dany2701/BOM-project/Project/CAD/Main.png

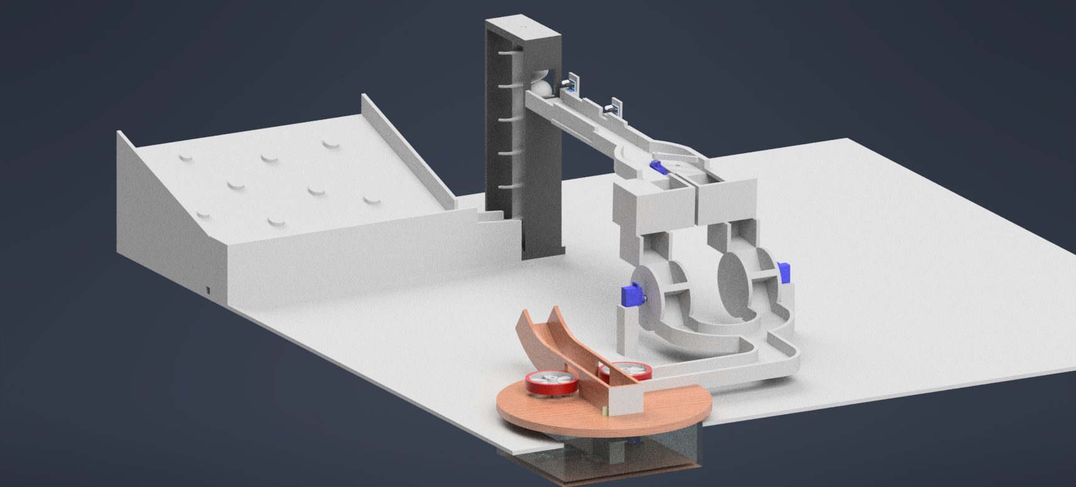
Project/CAD/Main.png
