dany2701/BOM-project/Project/Documentation/Actuator_Sizing_Report_Gate2.docx

ACTUATOR SIZING FOR SORTING MECHANISM

For the sizing of the actuator used to move the gate ,I have decided that it must be a servo motor to be able to move the gate between 2 exact positions , however I had to do some calculations in order to find the model needed to achieve the needed motion.

# 1. Gate Physical Properties

The following data was extracted directly from Autodesk Inventor iProperties for the gate2 component. The gate is manufactured from MDF Medium Density Fiberboard with a density of 0.800 g/cm³.

Parameter | Value | Unit
Mass | 0.001 | kg (~1 g)
Volume | 1643.915 | mm³
Surface Area | 1428.832 | mm²
CoG Offset X | -1.223 | mm
CoG Offset Y | -2.168 | mm
CoG Offset Z | 1.500 | mm
Principal Moment I1 | 0.400 | kg·mm²
Principal Moment I2 | 0.009 | kg·mm²
Principal Moment I3 | 0.398 | kg·mm²
Material | MDF Medium Density Fiberboard | —
Density | 0.800 | g/cm³

# 2. Operating Parameters

The following operating conditions were specified for the sorting mechanism:

Parameter | Value | Notes
Swing Range | 40° – 120° | 80° total travel
Operating Speed | < 0.3 s per stroke | Fast sorting cycle

# 3. Torque Analysis

## 3.1 Effective Moment of Inertia

For a center-pivot gate, the effective rotational inertia about the pivot axis is taken as the average of the two principal moments in the plane of rotation (I1 and I3):

I_eff: (I1 + I3) / 2 = (0.400 + 0.398) / 2 = 0.399 kg·mm² = 3.99 × 10⁻⁷ kg·m²

## 3.2 Static Gravitational Torque

The moment arm is the horizontal projection of the CoG offset from the pivot centre. The dominant offset is in Y (2.168 mm):

τ_grav: m × g × r_CoG = 0.001 × 9.81 × 0.00217 ≈ 0.0000213 N·m ≈ 0.021 mN·m

## 3.3 Dynamic (Acceleration) Torque

Assuming constant angular acceleration to traverse 80° (1.396 rad) in 0.3 s:

α: 2θ / t² = 2 × 1.396 / 0.3² ≈ 31.0 rad/s²

τ_acc: I_eff × α = 3.99×10⁻⁷ × 31.0 ≈ 0.0124 mN·m ≈ 0.012 mN·m

## 3.4 Design Torque with Safety Factor

A safety factor of 3× is applied to account for payload impact forces, air resistance, and mechanical wear. An additional 10–20% is added for friction losses at the pivot bearing:

τ_design: (τ_grav + τ_acc) × 3 × 1.15 ≈ 0.033 × 3.45 ≈ 0.114 → rounded to 0.12 mN·m

Torque Component | Value | Formula / Basis
Static gravitational | 0.021 mN·m | m × g × r_CoG
Dynamic (acceleration) | 0.012 mN·m | I_eff × α
Raw total | 0.033 mN·m | Static + dynamic
With safety factor (3×) | 0.099 mN·m | 3× margin applied
Design torque (+ friction) | 0.12 mN·m | Rounded up for losses

# 4. Servo Selection Criteria

The following minimum specifications are required for the servo actuator. Speed is the binding constraint — the gate mass is negligible (~1 g), so torque margin is very large with any standard hobby servo.

Parameter | Required | Rationale | Priority
Stall torque | ≥ 0.5 mN·m | 5× margin over design | Low
Speed | ≥ 266 °/s | 80° in < 0.3 s | CRITICAL
Rotation range | ≥ 80° travel | Full gate sweep | High
Resolution | ≤ 1° preferred | Accurate gate stop | Medium
Supply voltage | 3.3 V or 5 V | MCU compatibility | Medium

# 5. Recommended Servo Options

All three options below provide 150–200× more torque than required. Selection is driven entirely by speed capability and physical size constraints.

Model | Torque | Speed | Weight | Notes
MG90S | 22 mN·m | ~500 °/s | 13 g | Metal gear, durable
DS-929MG | 30 mN·m | ~460 °/s | 11 g | Higher torque margin

# 7. Summary

The gate2 component is extremely lightweight (~1 g, MDF) with a symmetrical center-pivot configuration. Torque demand is negligible at 0.12 mN·m design torque. Any standard micro-servo exceeds this by 150× or more. The sole engineering constraint is cycle speed: the mechanism requires 80° of travel in under 0.3 s, demanding a servo rated at ≥ 266 °/s. The SG90/SG92R family (600 °/s) is the optimal choice — compact, fast, inexpensive, and widely available.
