dany2701/BOM-project/Project/Documentation/PDS_Formatted.docx

PRODUCT DESIGN SPECIFICATION

━━━━━━━━━━━━━━━━━━━━━━━━━━━━

Closed-Loop Single-Player Shooting Game Toy

DEFENSE MECHANISM

PROJECT TEAM

━━━━━━━━━━━━━━━━

1 | Yassien Ayman, 24P0112
2 | Abdullah Amr, 24P0206
3 | Daniel Youssef, 24P0321
4 | Farah Yasser, 24P
5 | Shahd Khalifa, 24P

━━━━━━━━━━━━━━━━

1 PRODUCT OVERVIEW

The proposed system is an automated, closed-loop interactive game designed for one player, combining mechanical motion and intelligent sorting to create an engaging experience. It is intended for use as a children's toy (ages 2–10) and as an entertainment system.

Balls are fed through a gravity-based slide and launched using a joystick-controlled shooting mechanism. They then move through a guided pathway involving transport, elevation using an Archimedes screw, and color-based classification.

A sensing unit detects the color of each ball (white or black), and a sorting mechanism directs them into designated channels. The balls are then returned to the shooting area, forming a continuous closed-loop cycle.

The system ensures smooth operation through synchronization between mechanical components and sensors. It is suitable for, mechatronics applications, and interactive gameplay due to its integration of multiple engineering principles.

2 OBJECTIVES

- Develop an integrated system combining mechanical motion, sensing, and control into a single functional unit.
- Design a reliable mechanism for continuous ball circulation within a closed-loop system.
- Achieve fast and accurate color-based classification of balls.
- Ensure smooth and reliable mechanical movement throughout all stages of the system.
- Optimize the system to minimize delays, energy consumption, and mechanical losses.
- Incorporate a user-friendly interface to allow players to interact with and monitor the system easily.
- Improve user engagement by integrating interactive and competitive elements.
- Design the system to be suitable for entertainment and mechatronics applications.

3 TARGET AUDIENCE

Primary Users

- Children aged 2 to 10 years.
- Parents and guardians supervising gameplay.
- Suitable for homes, nurseries, and early learning environments.

Secondary Users

- Engineering and mechatronics students.
- Educational institutions (labs and demonstrations).

4 POWER CONSUMPTION

The system operates using low-voltage DC power (5V–12V) for safety and portability. The main power consumers are actuators, sensors, and the control unit.

Power consumption is kept low to moderate depending on motor load, with peak usage occurring when multiple actuators operate simultaneously.

Efficiency is improved by using gravity-fed ball movement and sensor-based activation, ensuring that components only operate when required.

5 FUNCTIONAL REQUIREMENTS

5.1. Ball Feeding System

- The system shall include a gravity-fed slide mechanism that delivers balls directly to the shooting mechanism.
- Balls shall be placed on the slide before operation begins.
- No manual insertion of balls shall be required during operation.

5.2. Shooting Mechanism

- The shooting mechanism shall launch one ball at a time in a controlled manner.
- The shooting mechanism shall receive balls automatically from the gravity-fed slide.
- The shooting action shall be triggered by the user using a joystick interface.
- The system shall ensure consistent shooting force for each launch.
- The system shall ensure smooth transition of balls from the slide into the shooting unit without jamming.

5.3. Joystick Control

- The system shall include a joystick for user interaction.
- The joystick shall be used to control the shooting action (activation and timing).
- The system shall respond to joystick input in real time.
- The joystick shall be able to control shooting direction
- Input signals shall be converted into control signals for the shooting mechanism.

5.4. Lifting Mechanism

- The system shall use an Archimedes screw mechanism to lift balls from the lower level to the upper sorting stage.
- The screw shall rotate to transport balls vertically in a continuous and controlled manner.
- An entry sensor at the base of the lifting mechanism shall trigger the motor to start rotating when a ball is detected.
- An exit sensor at the top of the lifting mechanism shall stop the motor when a ball has cleared the screw.
- The lifting mechanism shall ensure smooth transfer of balls without jamming or delay.
- The system shall maintain continuous operation based on sensor feedback for efficient ball transport.
- The lifting motor has been selected based on torque requirements derived from the weight of a single ball and screw radius, with a suitable safety factor applied.

5.5. Sorting Mechanism

- The system shall include a color detection unit to identify balls as white or black.
- Color detection shall occur after the ball exits the lifting mechanism.
- The system shall process sensor input in real time to determine ball color.
- The system shall include a mechanical sorting gate to direct balls based on detected color:
- White balls → Designated white path
- Black balls → Designated black path
- The sorting mechanism shall operate automatically without user intervention.
- The system shall ensure high accuracy in sorting and minimize misclassification.

5.6. Closed-Loop Operation

- The system shall operate as a continuous closed-loop cycle without manual resetting.
- After sorting, balls shall be automatically returned to the initial shooting region.
- The return system shall ensure smooth transport of balls back to the gravity-fed slide.
- The system shall ensure synchronization between: the shooting mechanism, the lifting system, and the sorting system.
- The loop shall only stop when the system is manually powered off.

6 NON-FUNCTIONAL REQUIREMENTS

6.1. Reliability & Performance

- The system shall operate continuously for extended periods without failure.
- Smooth and continuous ball movement shall be maintained without jamming.
- The shooting mechanism shall respond reliably to joystick input.
- The lifting mechanism shall operate consistently using sensor feedback.
- The system shall accurately sort balls into white and black categories.
- Stable performance shall be maintained during repeated gameplay.

6.2. Safety

- The system shall enclose all moving parts to prevent user injury.
- The system shall operate using low-voltage electrical components.
- Materials shall be non-toxic and safe for children.
- Edges and surfaces shall be smooth and rounded.
- All electrical wiring shall be fully enclosed within the chassis to prevent user contact and tampering.

6.3. Usability

- The system shall be easy to use with simple controls.
- The system shall require minimal setup before operation.
- The interface shall be understandable for children aged 2–10 years.

6.4. Product Lifespan

- The system shall be designed for repeated use over long periods.
- Mechanical components shall withstand frequent operation.
- The product shall maintain functionality with proper use and care.

6.5. Size & Weight

- The weight shall be manageable to allow easy movement by adults.
- The dimensions shall ensure safe interaction and accessibility for children.
- The layout shall efficiently utilize a 100 cm × 100 cm area to accommodate all mechanical and electronic components.

6.6. Maintainability

- Easy access to internal components shall be provided.
- Ball pathways and sensors shall be simple to clean.
- Mechanical and electrical parts shall be replaceable.

6.7. Aesthetic Considerations

- The design shall be colorful and visually attractive to children.
- A war themed design is included to appeal to the respected audience
- The system layout shall be clean and organized.
- Functional areas shall be clearly distinguishable.

6.8. Ergonomics & User Interaction

- The joystick shall be easy to use for small hands.
- Controls shall require minimal force to operate.
- The interface shall be simple and understandable for children.
- The design shall ensure comfortable and safe interaction.

6.9. Manufacturing

- 3D printing shall be used for complex mechanical parts.
- Laser cutting shall be used for structural components.
- Standard assembly methods such as screws and fittings shall be used.
- Materials such as PLA shall be selected for safety and availability.

7 OPERATIONAL SPEED & EFFICIENCY

The system is designed for continuous and stable operation rather than high speed. Balls move through a closed-loop cycle involving feeding, shooting, lifting, sorting, and return.

Efficiency is achieved through gravity-assisted movement, real-time sensor control, and synchronized subsystem operation. This reduces delays, prevents congestion, and ensures smooth circulation of balls throughout the system.

8 SYSTEM COMPONENTS

8.1 Mechanical Components

- Shooting mechanism (spring or motor-based)
- Ball transport channels
- Lifting system (Archimedes screw)
- Sorting gates
- Frame and housing

8.2 Electrical Components

- DC motors
- Servo motors
- Motor driver
- Power supply
- IR sensors
- Control circuit (microcontroller)

9 INPUTS & OUTPUTS

Inputs | Outputs
Player shooting action | Ball movement
Sensor signals (color detection) | Sorting direction
Joystick & push-button | Motor activation

10 TESTING & VALIDATION

The following tests shall be performed to verify system performance prior to final sign-off:

1. Test color detection accuracy — validate correct classification of white and black balls under operational conditions.
2. Verify smooth ball movement — confirm unobstructed flow through all pathways from feeding through to return.
3. Check lifting efficiency — assess Archimedes screw performance under continuous load.
4. Ensure correct sorting operation — validate gate actuation and directional accuracy.
5. Run continuous cycle test — operate the full closed-loop system for an extended period to confirm reliability and identify any failure modes.

Product Design Specification | Closed-Loop Single-Player Shooting Game
