dany2701/BOM-project/Project/Documentation/PRODUCT DESIGN SPECIFICATION.pdf

## PRODUCT DESIGN SPECIFICATION

## Project Title

Closed-Loop Two-Player Shooting Game Toy

## Product Overview:

The proposed system is an automated, closed-loop interactive game designed for two players, combining mechanical motion and intelligent sorting to create an engaging experience. It is intended for use as a children’s toy (ages 2–10) and as an educational demonstration system.

Balls are fed through a gravity-based slide and launched using a joystick-controlled shooting mechanism. They then move through a guided pathway involving transport, elevation using an Archimedes screw, and color-based classification.

A sensing unit detects the color of each ball (white or black), and a sorting mechanism directs them into designated channels. The balls are then returned to the shooting area, forming a continuous closed-loop cycle.

The system ensures smooth operation through synchronization between mechanical components and sensors. It is suitable for educational demonstrations, mechatronics applications, and interactive gameplay due to its integration of multiple engineering principles.

## Objectives

- Develop an integrated system that combines mechanical motion, sensing, and control into a single functional unit.
- Design a reliable mechanism for continuous ball circulation within a closed-loop system.
- Achieve fast and accurate color-based classification of balls.
- Ensure smooth and reliable mechanical movement throughout all stages of the system
- Optimize the system to minimize delays, energy consumption, and mechanical losses.
- Incorporate a user-friendly interface to allow players to interact with and monitor the system easily.
- Enable wireless communication between the hardware system and the application using Bluetooth technology.
- Improve user engagement by integrating interactive and competitive elements.
- Design the system to be suitable for educational and mechatronics applications.

## Power Consumption

The system operates using low-voltage DC power (5V–12V) for safety and portability. The main power consumers are DC motors, sensors, and the control unit.

Power consumption is kept low to moderate depending on motor load, with peak usage occurring when multiple actuators operate simultaneously.

Efficiency is improved by using gravity-fed ball movement and sensor-based activation, ensuring that components only operate when required.

## Target Audience

- Primary users: Children aged 2 to 10 years.
- Secondary users: Parents and guardians supervising gameplay.
- Suitable for homes, nurseries, and early learning environments.
- Engineering and mechatronics students.
- Educational institutions (labs and demonstrations).

## Functional Requirements

1. Ball Feeding System
- The system shall include a gravity-fed slide mechanism that delivers balls directly to the shooting mechanism.
- Balls shall be placed on the slide before operation begins..
- No manual insertion of balls shall be required during operation.
2. Shooting Mechanism
- The shooting mechanism shall launch one ball at a time in a controlled manner.
- The shooting mechanism shall receive balls automatically from the gravity-fed slide.
- The shooting action shall be triggered by the user using a joystick interface.
- The system shall ensure consistent shooting force for each launch.
- The system shall ensure smooth transition of balls from the slide into the shooting unit without jamming.

3. Joystick Control
- The system shall include a joystick for user interaction.
- The joystick shall be used to control the shooting action (activation and timing).
- The system shall respond to joystick input in real time.
- The input signals shall be converted into control signals for the shooting mechanism.
4. Lifting Mechanism
- The system shall use an Archimedes screw mechanism to lift balls from the lower level to the upper sorting stage.
- The screw shall rotate to transport balls vertically in a continuous and controlled manner.
- The system shall include an entry sensor at the base of the lifting mechanism, when the entry sensor detects a ball entering the screw, it will trigger the motor to start rotating
- The system shall include an exit sensor at the top of the lifting mechanism,when the exit sensor detects that a ball has left the screw, it will stop the motor operation accordingly.
- The lifting mechanism shall ensure smooth transfer of balls without jamming or delay
- The system shall maintain continuous operation based on sensor feedback for efficient ball transport.
- The lifting motor has been selected based on torque requirements derived from the weight of a single ball and screw radius. A suitable safety factor has been applied to ensure reliable operation under continuous load.
5. Sorting Mechanism
- The system shall include a color detection unit to identify balls as white or black.
- The color detection shall occur after the ball exits the lifting mechanism.
- The system shall process sensor input in real time to determine ball color.
- The system shall include a mechanical sorting gate.
- Based on the detected color, the system shall direct the ball into the correct output path
- White balls → designated white path

- Black balls → designated black path
- The sorting mechanism shall operate automatically without user intervention.
- The system shall ensure high accuracy in sorting and minimize misclassification.
- The actuator for the shooting mechanism was sized to achieve a consistent launch force sufficient to deliver balls to the entry point without jamming.
6. Closed Loop System
- The system is required to operate as a continuous closed-loop cycle without manual resetting.
- After sorting, balls should be automatically returned to the initial shooting region .
- The return system shall ensure smooth transport of balls back to the gravity-fed slide.
- The system shall ensure synchronization between:
- Shooting mechanism
- Lifting system
- Sorting system
- The loop shall only stop when the system is manually powered off.

## Non-Functional Requirements

1. Reliability & Performance Considerations
- The system shall operate continuously for extended periods without failure.
- The system shall ensure smooth and continuous ball movement without jamming
- The shooting mechanism shall respond reliably to joystick input
- The lifting mechanism shall operate consistently using sensor feedback
- The system shall accurately sort balls into white and black categories
- The system shall maintain stable performance during repeated gameplay .

2. Safety
- The system shall enclose all moving parts to prevent user injury.
- The system shall operate using low-voltage electrical components.
- Materials shall be non-toxic and safe for children.
- Edges and surfaces shall be smooth and rounded .
- All electrical wiring should be fully enclosed within the chassis to prevent user contact and tampering.
3. Usability
- The system shall be easy to use with simple controls .
- The system shall require minimal setup before operation.
- The interface shall be understandable for children aged 2-10 years.

4.Product Life Span

- The system shall be designed for repeated use over long periods.
- Mechanical components shall withstand frequent operation.
- The product shall maintain functionality with proper use and care.
5. Size and Weight Restrictions
- The weight shall be manageable to allow easy movement by adults.
- The dimensions shall ensure safe interaction and accessibility for children.
- The layout shall efficiently utilize the 100 cm × 100 cm area to accommodate all mechanical and electronic components
6. Maintainability
- Easy access to internal components
- Simple cleaning of ball pathways and sensors
- Replaceable mechanical and electrical parts
7. Aesthetic Considerations
- The design shall be colorful and visually attractive to children.

- The system layout shall be clean and organized..
- Functional areas shall be clearly distinguishable
8. Ergonomics & User Interaction
- The joystick shall be easy to use for small hands.
- Controls shall require minimal force to operate.
- The interface shall be simple and understandable for children.
- The design shall ensure comfortable and safe interaction.
9. Manufacturing Processes
- 3D printing shall be used for complex mechanical parts.
- Laser cutting shall be used for structural components.
- Standard assembly methods such as screws and fittings shall be used.
- Materials such as PLA shall be selected for safety and availability.

## Operational Speed & Efficiency

The system is designed for continuous and stable operation rather than high speed. Balls move through a closed-loop cycle involving feeding, shooting, lifting, sorting, and return.

Efficiency is achieved through gravity-assisted movement, real-time sensor control, and synchronized subsystem operation. This reduces delays, prevents congestion, and ensures smooth circulation of balls throughout the system

## System Components

1.Mechanical Components

- Shooting mechanism (spring or motor-based).
- Ball transport channels.
- Lifting system (e.g., Archimedes screw).
- Sorting gates.
- Frame and housing

2. Electrical Components
- DC motors.
- Servo Motors.
- Motor driver.
- Power supply.
- IR sensors.
- Control circuit (microcontroller) .

## Inputs and Outputs

Inputs

- Player shooting action
- Sensor signals (color detection)

Outputs

- Ball movement
- Sorting direction
- Motor activation

### Testing & Validation

- Test color detection accuracy
- Verify smooth ball movement
- Check lifting efficiency
- Ensure correct sorting operation
- Run continuous cycle test
