dany2701/BOM-project/Project/Documentation/LIFTINGG (1).pdf

Archimedes Screw Lift

### 1. Number of Screw Revolutions Required

In an Archimedes screw mechanism, each full rotation lifts the object by a distance equal to the pitch.
Given:
Pitch = 1.2 mm
Total lift length:

L = 255.203 + 70
L = 325.203 mm

Number of revolutions:

N =

L
Pitcℎ

N =

325.203
1.2
N ≈ 271 revolutions

Therefore, the screw must rotate approximately 271 revolutions to lift the ball from the bottom to the top.

### 2. Relationship Between Motor Speed and Screw Speed

Since the motor shaft is directly connected to the screw shaft using a Rigid Coupling, the transmission ratio is 1:1.

RPM = RPM

This means the screw rotates at the same speed as the motor.

### 3. Time Required for Lifting

Case 1: Motor speed = 100 RPM Convert RPM to revolutions per second:

100/60 = 1.67 rps

Time required:

t =

N
rps

t =

271
1.67
t ≈ 162 s

Which is approximately:

### 2.7 minutes

Case 2: Motor speed = 200 RPM Convert RPM to rps:

200/60 = 3.33 rps

Time required:

t =

271
3.33
t ≈ 81 s

Which is approximately:

### 1.3 minutes

### 4. Torque Required to Rotate the Screw

Mass of the ball:

m = 0.015 kg

Force required to lift the ball:

F = mg

F = 0.015 × 9.81
F = 0.147 N

Screw Dimensions
Screw diameter:

D = 27 mm

Radius:

r = 13.5 mm = 0.0135 m

Torque Equation

T =

F × r
η

Where:
η = mechanical eiciency of the screw (≈0.6 for 3D printed parts)

T =

0.147 × 0.0135
0.6
T = 0.0033 N ⋅ m

### 5. Eect of the Rigid Coupling

The Rigid Coupling transmits torque almost directly with very small losses. Typical eiciency:

η ≈ 0.98

Required motor torque:

T =

T
0.98
T ≈ 0.0034 N ⋅ m

### 6. Safety Factor

To account for friction and design uncertainties, a safety factor of 3 is applied.

T = 0.0034 × 3
T ≈ 0.01 N ⋅ m

### 7. Motor Selection

Recommended motor specifications: Motor type: Micro DC Gear Motor Voltage: 12 V
Speed: 150 – 200 RPM
Torque:

T ≥ 0.1 N ⋅ m

This torque is significantly higher than the required torque, ensuring safe and reliable operation.

Electrical Components:
1. 12V N20 Micro Gear Motor (200 RPM)

### 2. Motor Driver Module (L298N) 3. Arduino Uno 4. Two IR sensors

5. 12V DC Power Source

Mechanical Components:

### 1. Flexible Beam Coupling (3mm to 5mm)

CODE

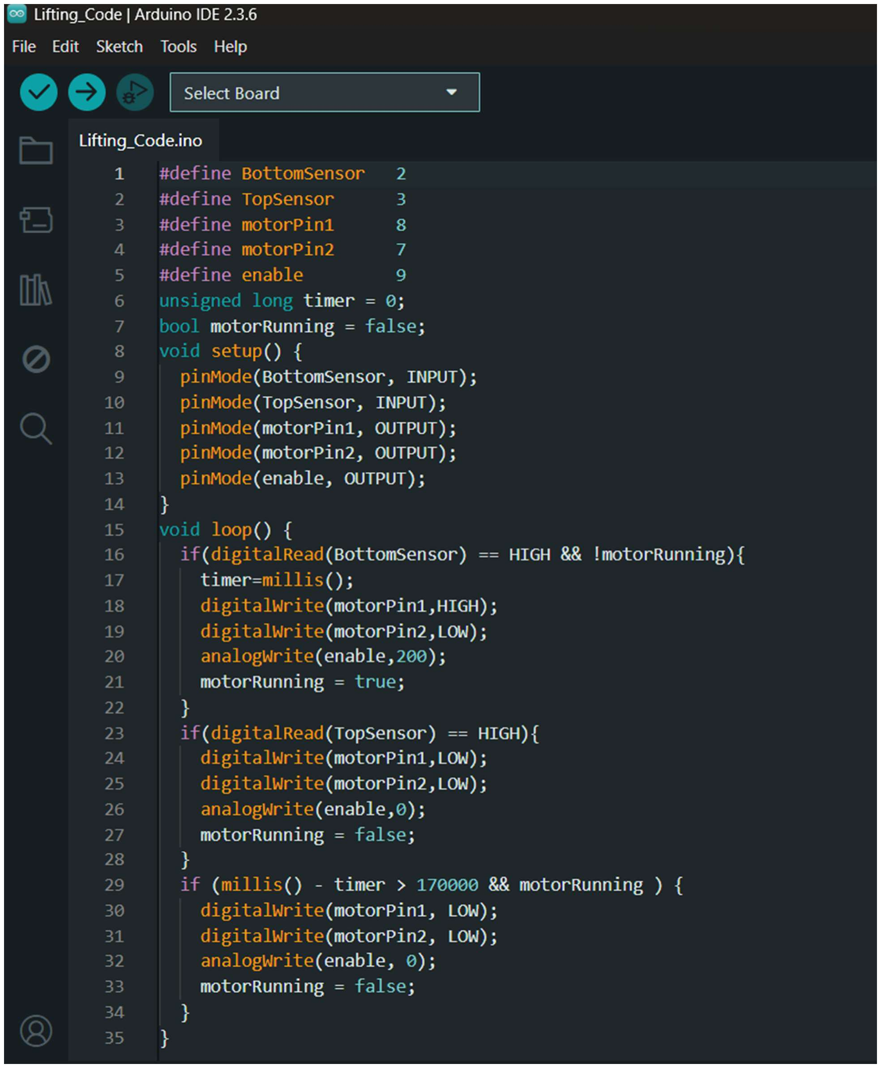
[picture p10: figure]
