dany2701/BOM-project/Project/CAD/Not needed/sample.JPG

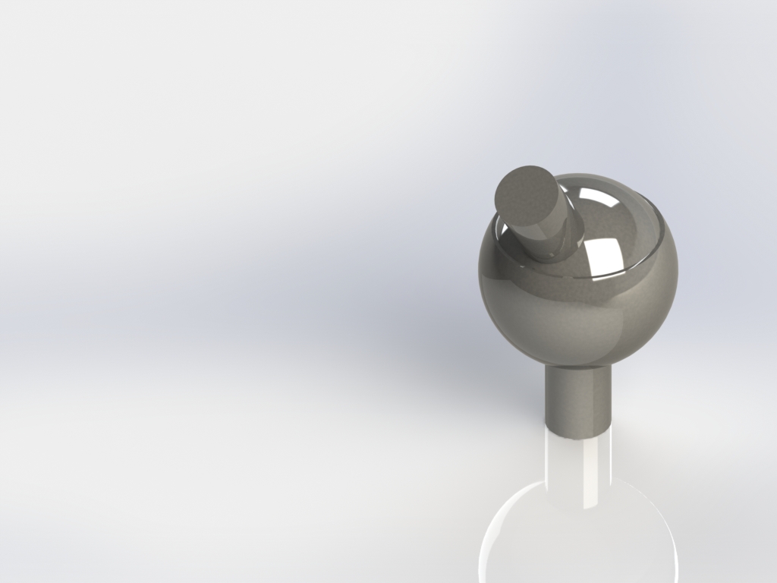
Project/CAD/Not needed/sample.JPG
