dany2701/BOM-project/Project/CAD/Shooting/Mini Push Pull Solenoid 4mm Stroke 2.jpg

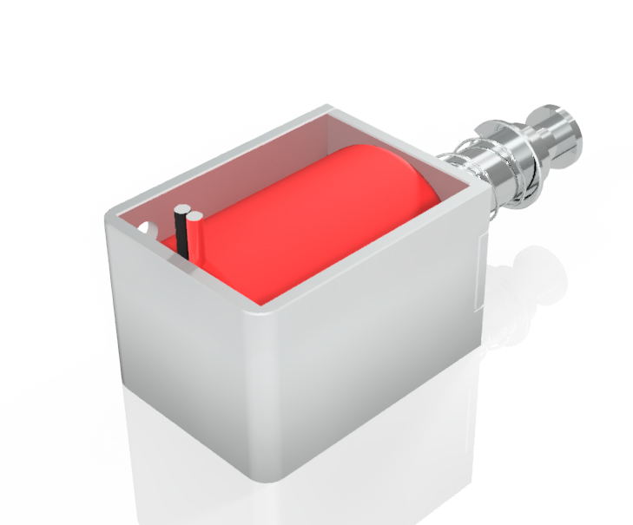
Project/CAD/Shooting/Mini Push Pull Solenoid 4mm Stroke 2.jpg
