dany2701/BOM-project/Project/CAD/Shooting/Mini Push Pull Solenoid 4mm Stroke 3.jpg

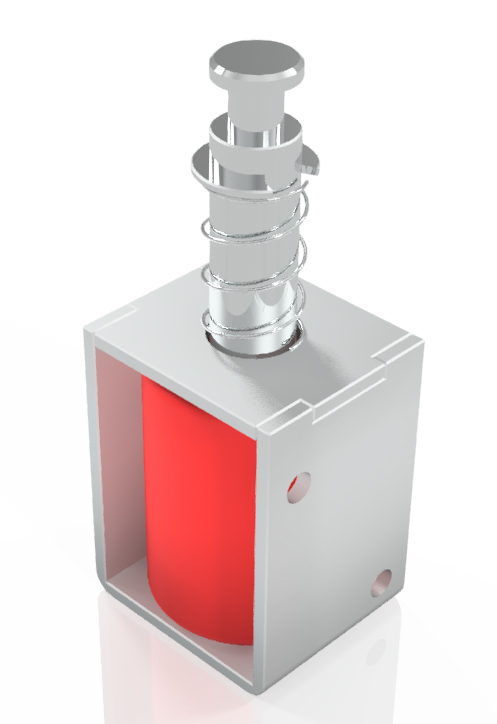
Project/CAD/Shooting/Mini Push Pull Solenoid 4mm Stroke 3.jpg
