dany2701/BOM-project/Project/CAD/SORTING.png

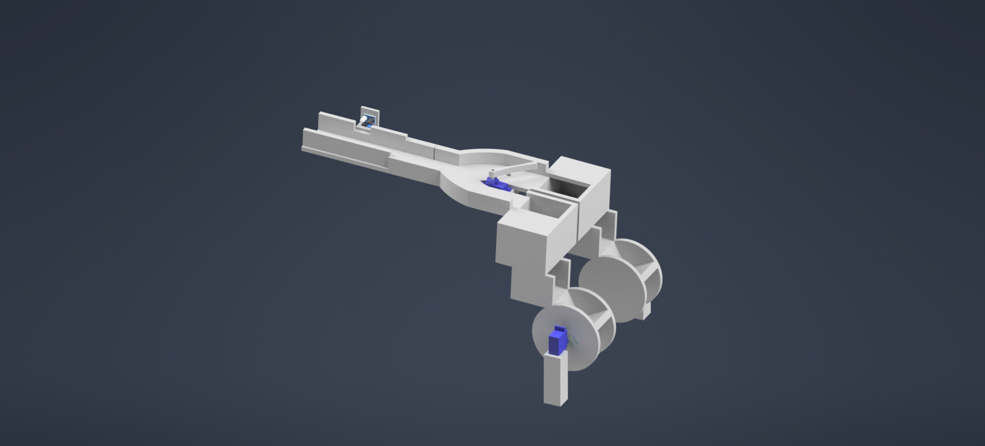
Project/CAD/SORTING.png
