dany2701/BOM-project/Project/Documentation/Parts.xlsx

Code | Part Name | Available No. | Needed No. | LIFTING MECHANISM |  | Sorting Mechanism
Sensors / Input
IR3PIN | IR Sensor | 1 | 3 | Part | # Needed | Parts
HC-SR04 | Ultrasonic Sensor | 1 |  | DC Motor | 1 | IR sensor | 1
KY040 | Rotary Encoder | 1 |  | H-bridge ( Motor Driver ) | 1 | Micro servo Motor | 2
Actuators |  |  |  | Arduino Uno | 1 | Arduino Uno | 1
FS90MG | Micro servo | 1 | 2 | IR Sensor | 2 | H-Bridge | 2
MG90S | Micro servo | 1
NEMA-17 | Stepper Motor | 1
 | DC motor | 2 | 1
L298 | H-Bridge | 1 | 3
 | Gear Pack | 2
Electrical / Arduino
A65 | Arduino Uno | 2 | 2
 | Aurduino Wire | 2
HC06 | Bluetooth Module | 1
1602 2C | LCD 2x16 | 1
 | Breadboards | 3
 | potentiometer | 1
 | 12V Adaptor | 1
