dany2701/BOM-project/Project/CAD/sorting/New Wood/MAIN.dxf

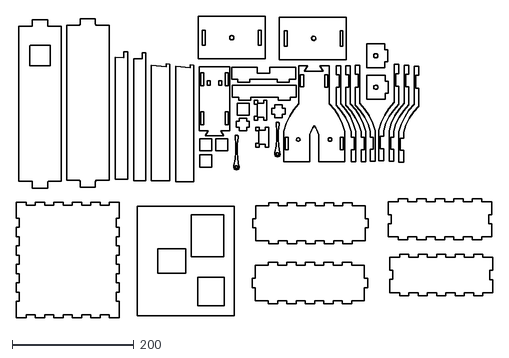
[picture p16: CAD file, 2026-04-29]
Project/CAD/sorting/New Wood/MAIN.dxf
784.5 x 495.5
