dany2701/BOM-project/Project/CAD/3D/IRsensorhub.stl

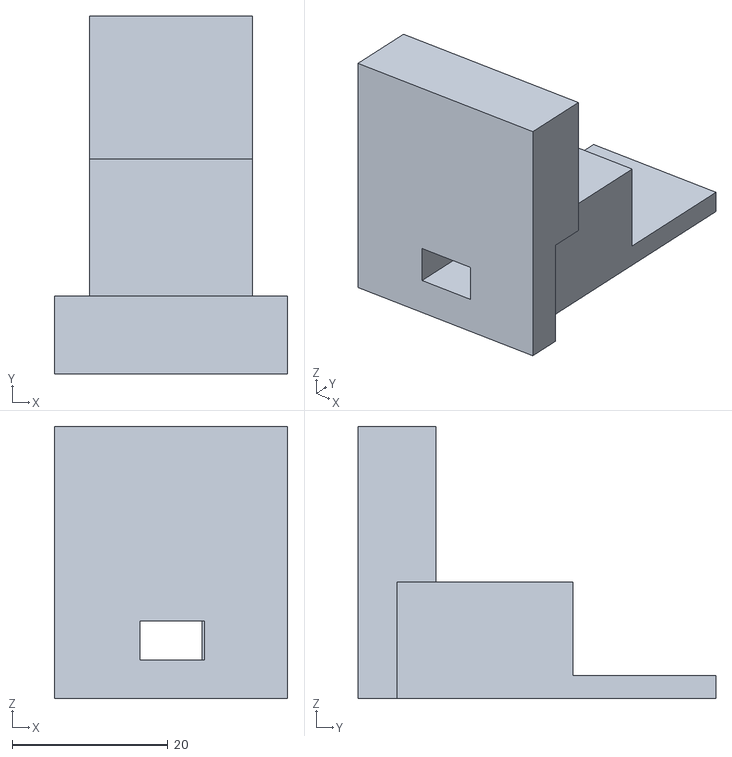
[picture p17: CAD file, 2026-04-29]
Project/CAD/3D/IRsensorhub.stl
30.0 x 46.0 x 35.0
