dany2701/BOM-project/Project/CAD/Lifting/Lifting Mechanism/IRsensors.STEP

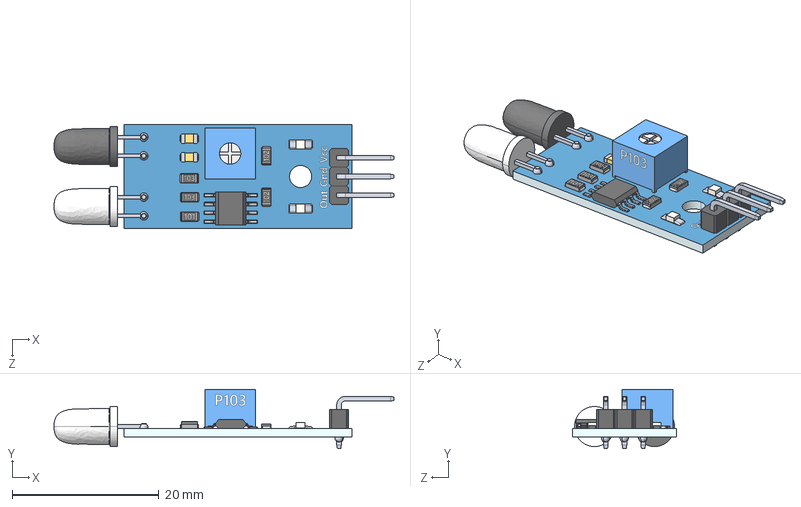
[picture p18: CAD file, 2026-04-29]
Project/CAD/Lifting/Lifting Mechanism/IRsensors.STEP
46.3 x 8.05 x 14.2 mm
IRboard
solder x 7
90headerMale x 3
blackLEDIRsensor
whiteLEDIRsensor
smdResistor101
smdResistor102 x 2
smdResistor103 x 2
smdceramiccapacitor x 2
smdLED x 2
smdTrimmerP103
smdChip8pin
