dany2701/BOM-project/Project/CAD/Not needed/motorstand3(remove1cmfromwidth).dxf

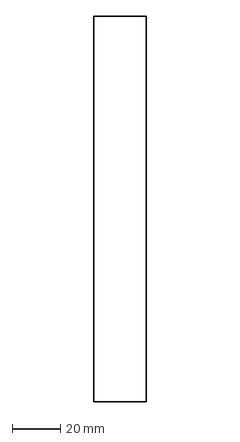
[picture p19: CAD file, 2026-04-29]
Project/CAD/Not needed/motorstand3(remove1cmfromwidth).dxf
22.0 x 160.0 mm
