dany2701/BOM-project/Project/CAD/Not needed/Shooting Mechanism CAD/wood/Box P4.dxf

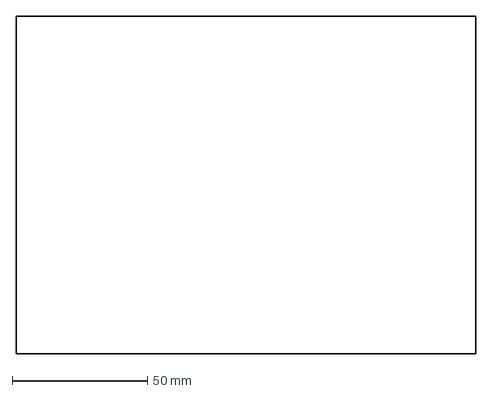
[picture p20: CAD file, 2026-04-29]
Project/CAD/Not needed/Shooting Mechanism CAD/wood/Box P4.dxf
170.0 x 125.0 mm
