dany2701/BOM-project/Project/CAD/Shooting/0837/0837 solenoid.stp

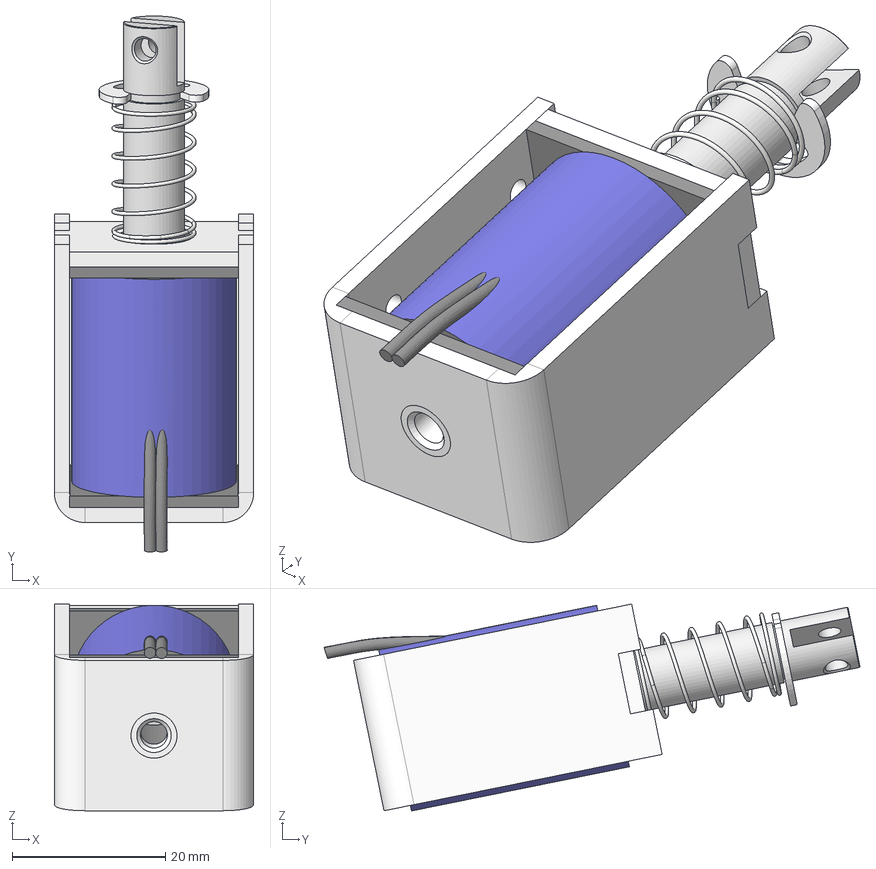
[picture p21: CAD file, 2026-04-29]
Project/CAD/Shooting/0837/0837 solenoid.stp
26.0 x 69.9 x 27.0 mm
base
cover
frame
coil
nut
kern
DIN 6799 - 7
Пружина сжатия1
