dany2701/BOM-project/Project/CAD/Shooting/dc motor mount-FINAL.stl

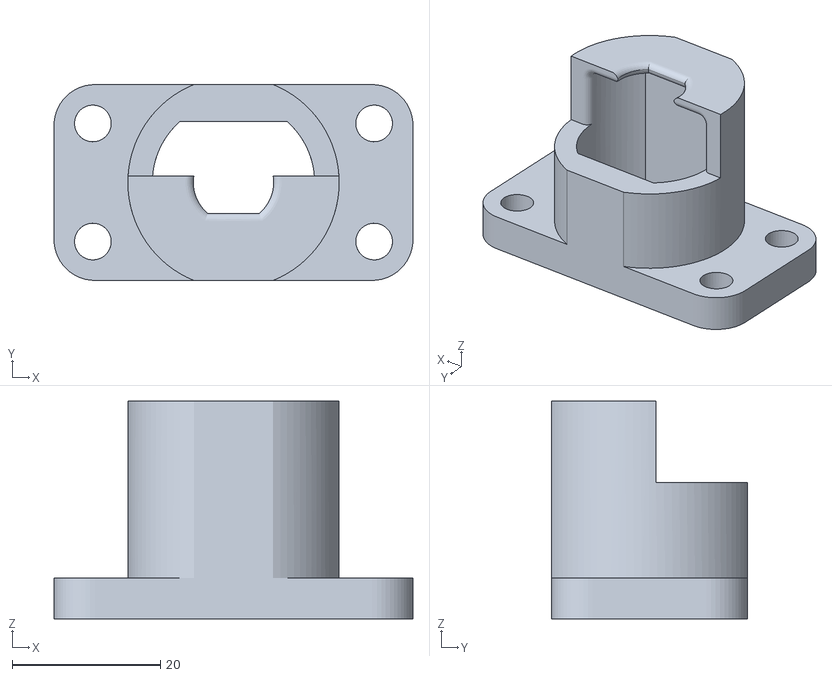
[picture p22: CAD file, 2026-04-29]
Project/CAD/Shooting/dc motor mount-FINAL.stl
48.4 x 26.4 x 29.4
