dany2701/BOM-project/Project/CAD/sorting/Towerpro Micro Servo 9g.SLDPRT

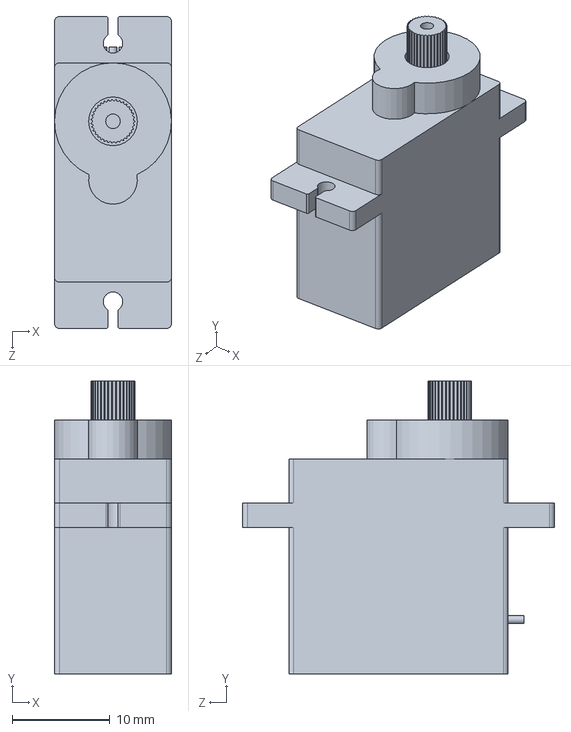
[picture p24: CAD file, 2026-03-11]
Project/CAD/sorting/Towerpro Micro Servo 9g.SLDPRT
12.0 x 30.0 x 32.0 mm
