dany2701/BOM-project/Project/CAD/sorting/Wood/Done/sortingslideoutline4.dxf

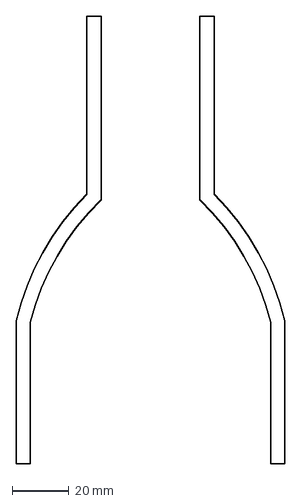
[picture p25: CAD file, 2026-04-29]
Project/CAD/sorting/Wood/Done/sortingslideoutline4.dxf
95.0 x 158.3 mm
