dany2701/BOM-project/Project/CAD/Ball Joint.STEP

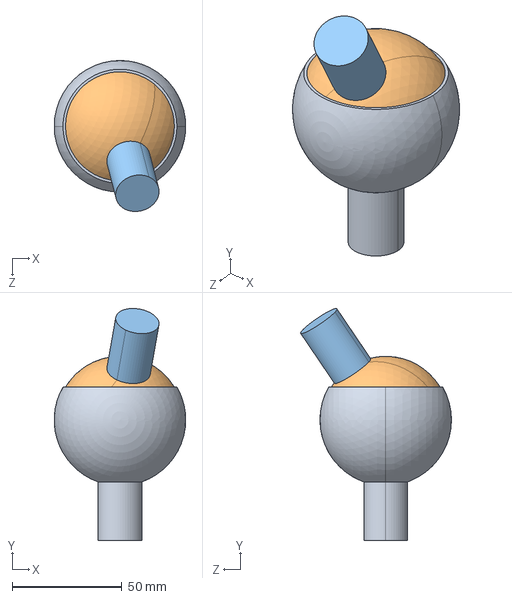
[picture p26: CAD file, 2026-03-11]
Project/CAD/Ball Joint.STEP
60.0 x 105.8 x 68.8 mm
Base
Ball
