dany2701/BOM-project/Project/CAD/Not needed/motorstand1x2.dxf

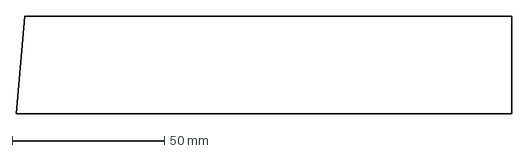
[picture p27: CAD file, 2026-04-29]
Project/CAD/Not needed/motorstand1x2.dxf
162.8 x 32.0 mm
