dany2701/BOM-project/Project/CAD/Not needed/Shooting Mechanism CAD/wood/Servo Stand Middle fixer.dxf

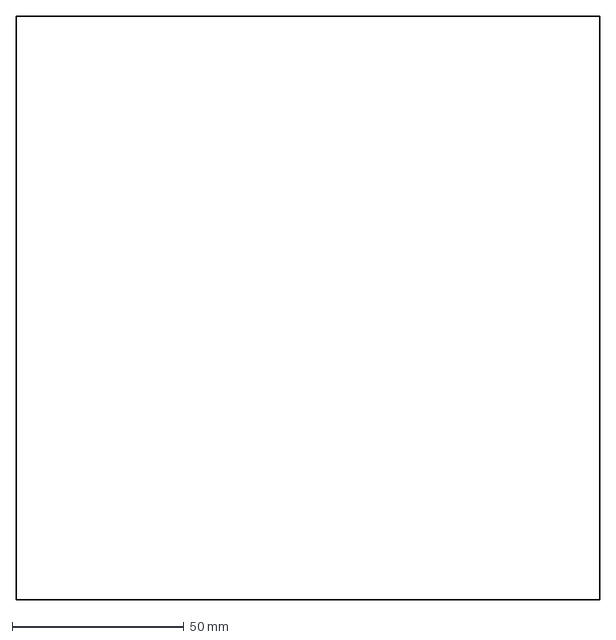
[picture p28: CAD file, 2026-04-29]
Project/CAD/Not needed/Shooting Mechanism CAD/wood/Servo Stand Middle fixer.dxf
170.0 x 170.0 mm
