dany2701/BOM-project/Project/CAD/sorting/New Wood/middleslsidewallx3.dxf

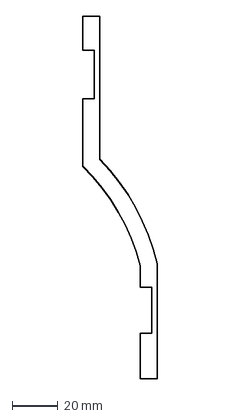
[picture p29: CAD file, 2026-04-29]
Project/CAD/sorting/New Wood/middleslsidewallx3.dxf
32.5 x 158.3 mm
