dany2701/BOM-project/Project/CAD/sorting/Wood/Done/sortinggate2.dxf

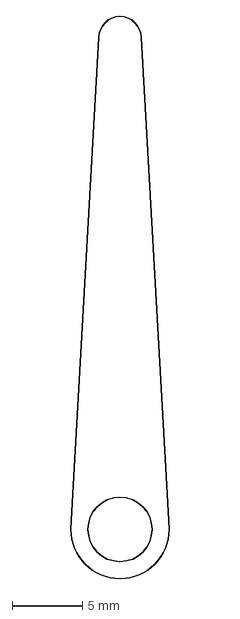
[picture p30: CAD file, 2026-04-29]
Project/CAD/sorting/Wood/Done/sortinggate2.dxf
7.00 x 40.0 mm
