dany2701/BOM-project/Project/CAD/Ball.SLDPRT

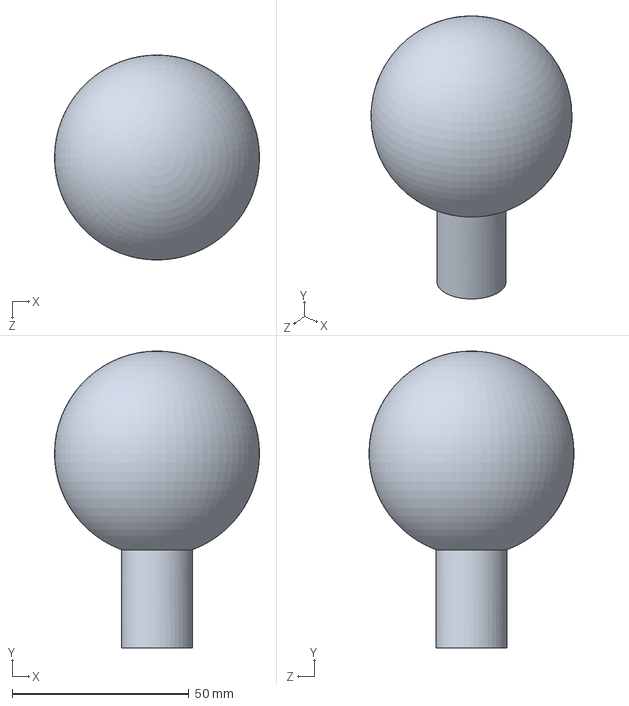
[picture p31: CAD file, 2026-03-11]
Project/CAD/Ball.SLDPRT
58.0 x 84.0 x 58.0 mm
