dany2701/BOM-project/Project/CAD/Not needed/anycurvewallx20.dxf

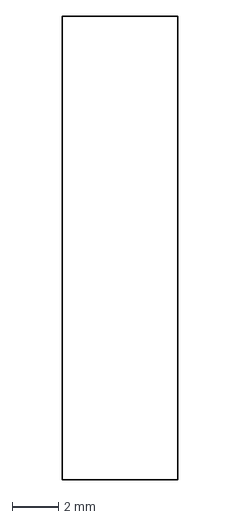
[picture p32: CAD file, 2026-04-29]
Project/CAD/Not needed/anycurvewallx20.dxf
5.00 x 20.0 mm
