dany2701/BOM-project/Project/CAD/Not needed/Shooting Mechanism CAD/wood/Box P1.dxf

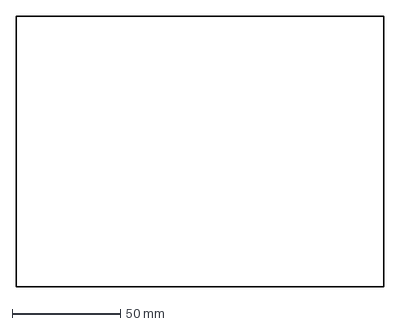
[picture p33: CAD file, 2026-04-29]
Project/CAD/Not needed/Shooting Mechanism CAD/wood/Box P1.dxf
170.0 x 125.0 mm
