dany2701/BOM-project/Project/CAD/sorting/New Wood/middleslide.dxf

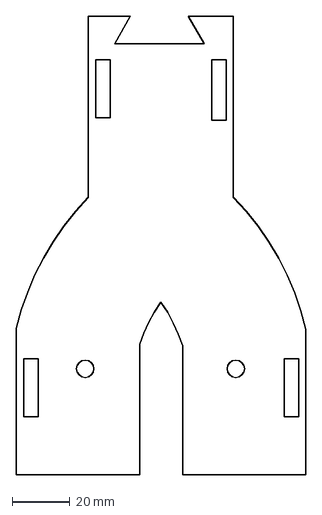
[picture p34: CAD file, 2026-04-29]
Project/CAD/sorting/New Wood/middleslide.dxf
99.9 x 158.3 mm
