dany2701/BOM-project/Project/CAD/sorting/Wood/Done/sortingslide.dxf

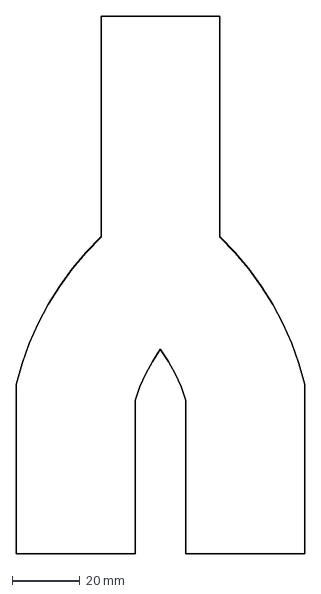
[picture p35: CAD file, 2026-04-29]
Project/CAD/sorting/Wood/Done/sortingslide.dxf
85.0 x 158.3 mm
