dany2701/BOM-project/Project/CAD/Base.SLDPRT

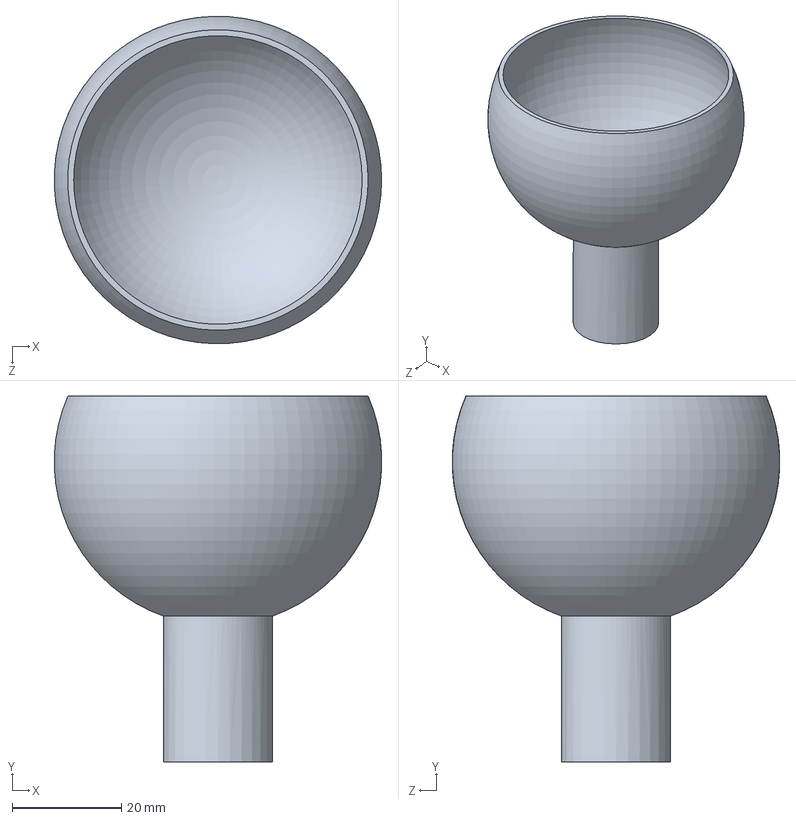
[picture p36: CAD file, 2026-03-11]
Project/CAD/Base.SLDPRT
59.9 x 67.0 x 59.9 mm
