dany2701/BOM-project/Project/CAD/Not needed/motorstand2(remove1cmfromwidth).dxf

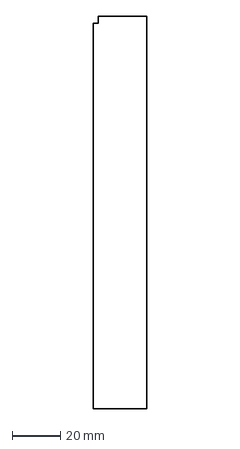
[picture p37: CAD file, 2026-04-29]
Project/CAD/Not needed/motorstand2(remove1cmfromwidth).dxf
22.0 x 162.8 mm
