dany2701/BOM-project/Project/CAD/Not needed/Shooting Mechanism CAD/wood/Grooved Base.dxf

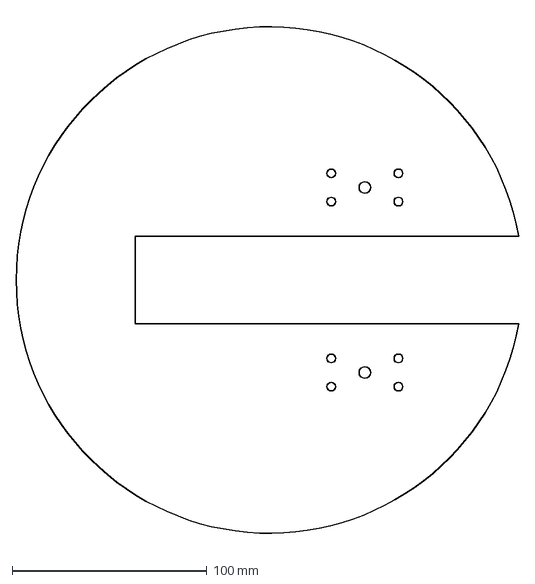
[picture p38: CAD file, 2026-04-29]
Project/CAD/Not needed/Shooting Mechanism CAD/wood/Grooved Base.dxf
258.0 x 270.7 mm
