dany2701/BOM-project/Project/CAD/sorting/New Wood/standx2.dxf

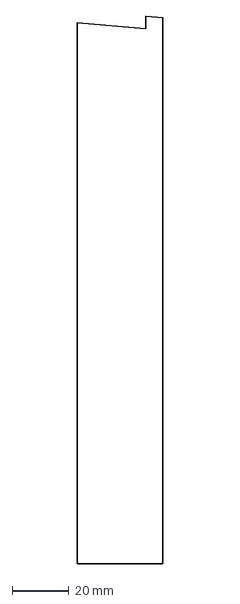
[picture p39: CAD file, 2026-04-29]
Project/CAD/sorting/New Wood/standx2.dxf
30.0 x 192.4 mm
