dany2701/BOM-project/Project/CAD/Not needed/middleslidestandx3.dxf

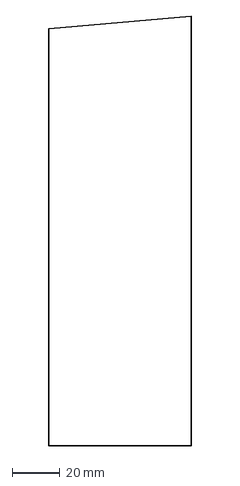
[picture p40: CAD file, 2026-04-29]
Project/CAD/Not needed/middleslidestandx3.dxf
60.0 x 180.6 mm
