dany2701/BOM-project/Project/CAD/Not needed/Shooting Mechanism CAD/wood/Servo Stand P2 X 2.dxf

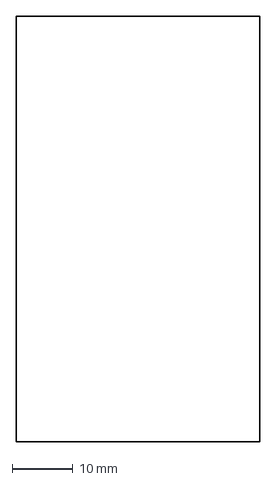
[picture p41: CAD file, 2026-04-29]
Project/CAD/Not needed/Shooting Mechanism CAD/wood/Servo Stand P2 X 2.dxf
40.0 x 70.0 mm
