dany2701/BOM-project/Project/CAD/Not needed/motorstandrest.dxf

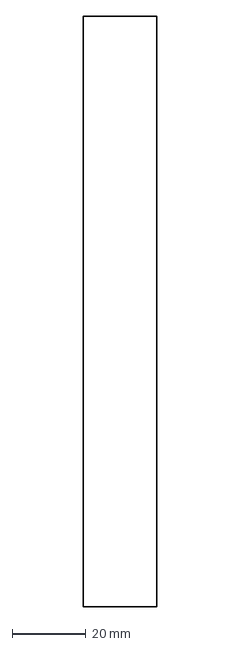
[picture p42: CAD file, 2026-04-29]
Project/CAD/Not needed/motorstandrest.dxf
20.0 x 160.0 mm
