dany2701/BOM-project/Project/CAD/Not needed/Shooting Mechanism CAD/wood/Box P3.dxf

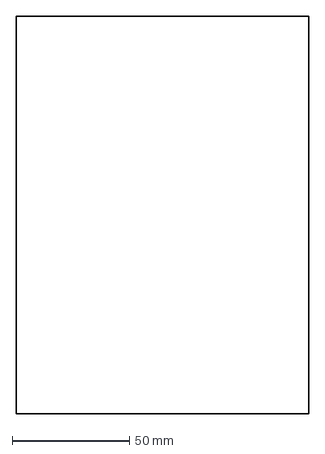
[picture p43: CAD file, 2026-04-29]
Project/CAD/Not needed/Shooting Mechanism CAD/wood/Box P3.dxf
125.0 x 170.0 mm
