dany2701/BOM-project/Project/CAD/sorting/New Wood/motorholderx2.dxf

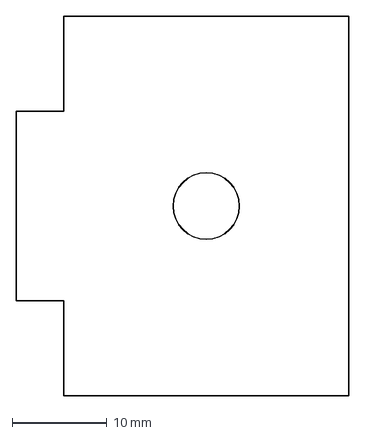
[picture p44: CAD file, 2026-04-29]
Project/CAD/sorting/New Wood/motorholderx2.dxf
35.0 x 40.0 mm
