dany2701/BOM-project/Project/CAD/Not needed/inslideface.dxf

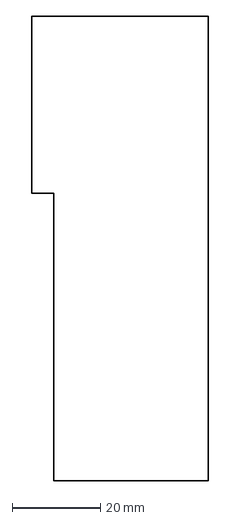
[picture p45: CAD file, 2026-04-29]
Project/CAD/Not needed/inslideface.dxf
40.0 x 105.0 mm
