dany2701/BOM-project/Project/CAD/Not needed/Shooting Mechanism CAD/wood/Base.dxf

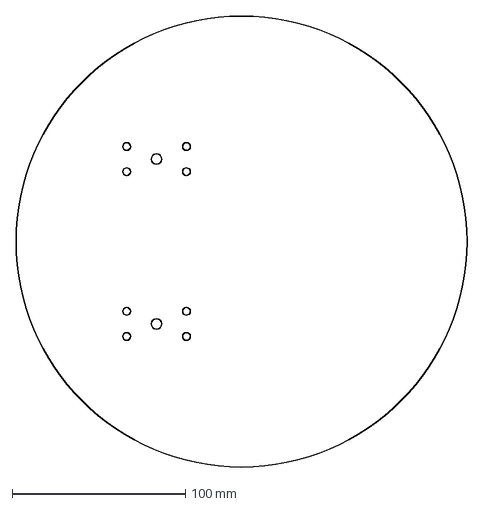
[picture p46: CAD file, 2026-04-29]
Project/CAD/Not needed/Shooting Mechanism CAD/wood/Base.dxf
260.0 x 260.0 mm
