dany2701/BOM-project/Project/CAD/sorting/New Wood/baseshooter2.dxf

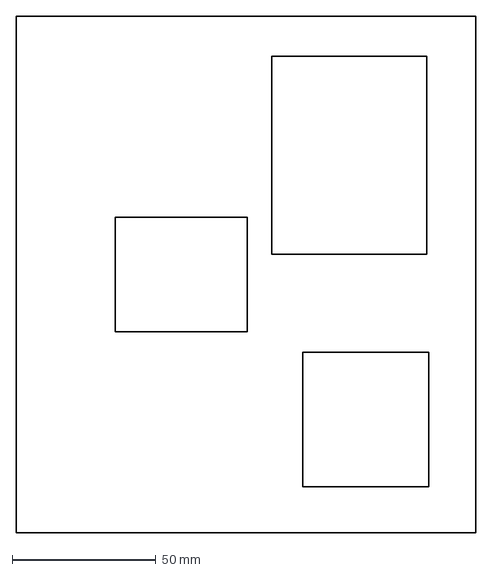
[picture p47: CAD file, 2026-04-29]
Project/CAD/sorting/New Wood/baseshooter2.dxf
160.0 x 180.0 mm
