dany2701/BOM-project/Project/CAD/Not needed/middleslidewall1x2.dxf

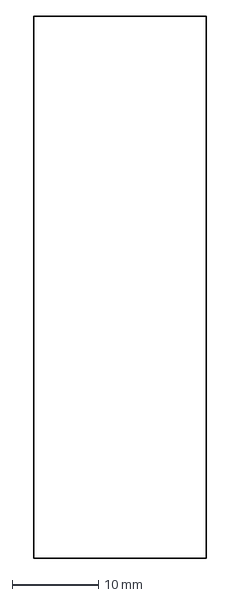
[picture p48: CAD file, 2026-04-29]
Project/CAD/Not needed/middleslidewall1x2.dxf
20.0 x 62.9 mm
