dany2701/BOM-project/Project/CAD/Not needed/Shooting Mechanism CAD/wood/Box P2.dxf

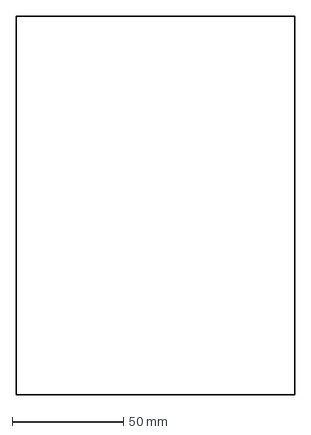
[picture p49: CAD file, 2026-04-29]
Project/CAD/Not needed/Shooting Mechanism CAD/wood/Box P2.dxf
125.0 x 170.0 mm
