dany2701/BOM-project/Project/CAD/sorting/New Wood/baseshooter.dxf

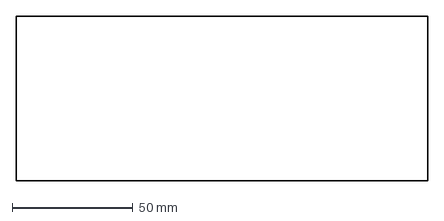
[picture p50: CAD file, 2026-04-29]
Project/CAD/sorting/New Wood/baseshooter.dxf
170.0 x 68.0 mm
