dany2701/BOM-project/Project/CAD/Not needed/middleslidewall3x4.dxf

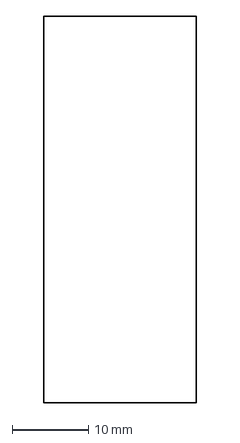
[picture p51: CAD file, 2026-04-29]
Project/CAD/Not needed/middleslidewall3x4.dxf
20.0 x 50.6 mm
