dany2701/BOM-project/Project/CAD/Not needed/Shooting Mechanism CAD/wood/Box Base.dxf

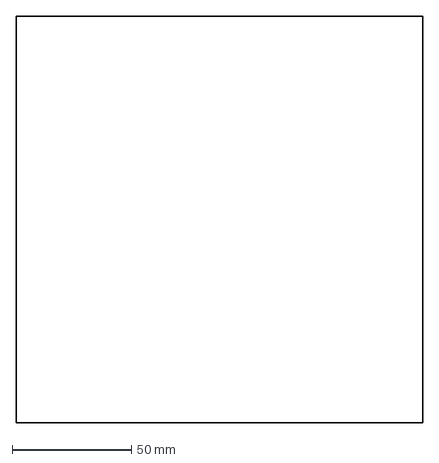
[picture p52: CAD file, 2026-04-29]
Project/CAD/Not needed/Shooting Mechanism CAD/wood/Box Base.dxf
170.0 x 170.0 mm
