dany2701/BOM-project/Project/CAD/sorting/New Wood/inslidewall1.dxf

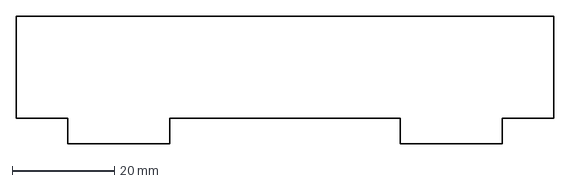
[picture p53: CAD file, 2026-04-29]
Project/CAD/sorting/New Wood/inslidewall1.dxf
105.0 x 25.0 mm
