dany2701/BOM-project/Project/CAD/Not needed/inslidewallx1.dxf

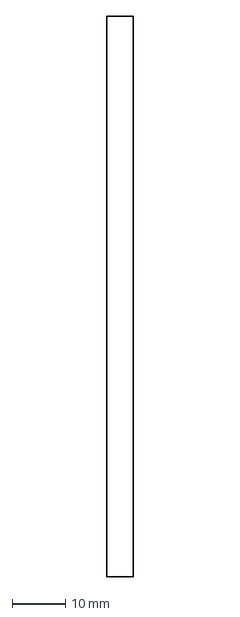
[picture p54: CAD file, 2026-04-29]
Project/CAD/Not needed/inslidewallx1.dxf
5.00 x 105.0 mm
