dany2701/BOM-project/Project/CAD/Not needed/Shooting Mechanism CAD/wood/Servo Stand Top.dxf

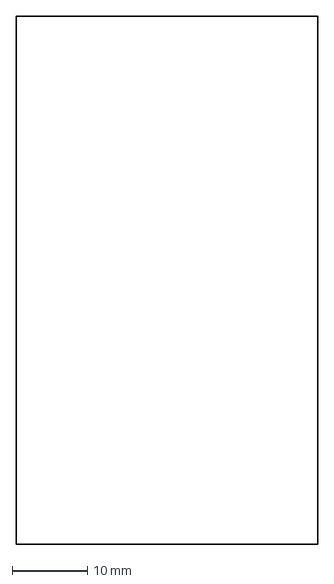
[picture p55: CAD file, 2026-04-29]
Project/CAD/Not needed/Shooting Mechanism CAD/wood/Servo Stand Top.dxf
40.0 x 70.0 mm
