dany2701/BOM-project/Project/CAD/sorting/New Wood/2standx2.dxf

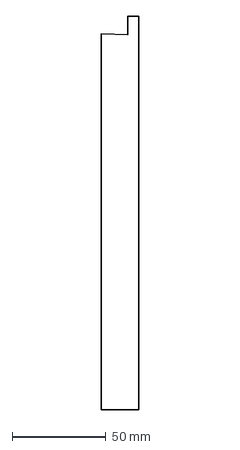
[picture p56: CAD file, 2026-04-29]
Project/CAD/sorting/New Wood/2standx2.dxf
20.0 x 210.0 mm
