dany2701/BOM-project/Project/CAD/Not needed/inslidewall2x1.dxf

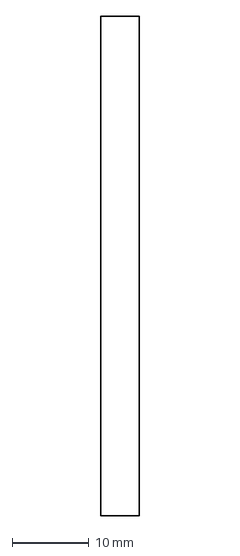
[picture p57: CAD file, 2026-04-29]
Project/CAD/Not needed/inslidewall2x1.dxf
5.00 x 65.0 mm
