dany2701/BOM-project/Project/CAD/Not needed/Shooting Mechanism CAD/wood/Graved Box Base.dxf

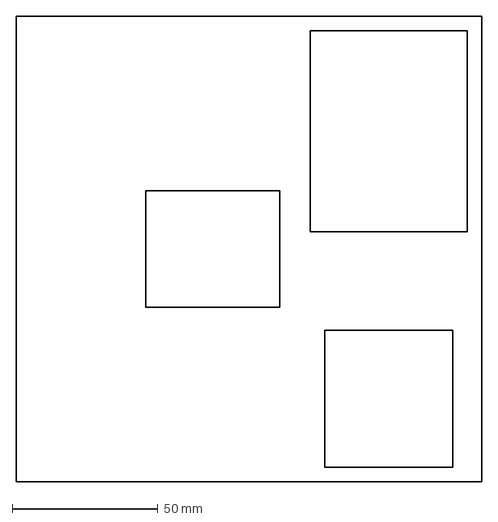
[picture p58: CAD file, 2026-04-29]
Project/CAD/Not needed/Shooting Mechanism CAD/wood/Graved Box Base.dxf
160.0 x 160.0 mm
