dany2701/BOM-project/Project/CAD/sorting/New Wood/motorholder2x2.dxf

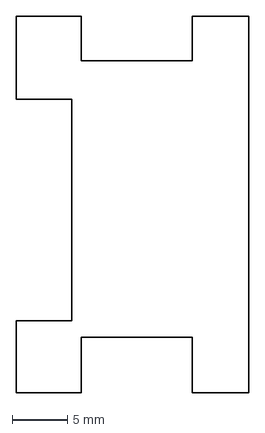
[picture p59: CAD file, 2026-04-29]
Project/CAD/sorting/New Wood/motorholder2x2.dxf
21.0 x 34.0 mm
