dany2701/BOM-project/Project/CAD/Not needed/Shooting Mechanism CAD/wood/Servo Stand P1 X 2.dxf

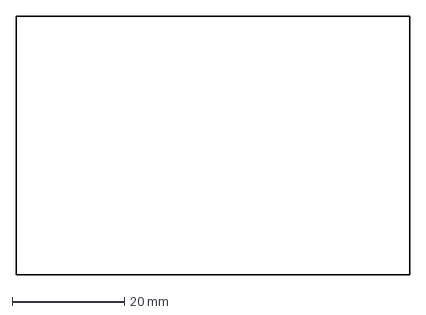
[picture p60: CAD file, 2026-04-29]
Project/CAD/Not needed/Shooting Mechanism CAD/wood/Servo Stand P1 X 2.dxf
70.0 x 46.0 mm
