dany2701/BOM-project/Project/CAD/sorting/New Wood/insideslide.dxf

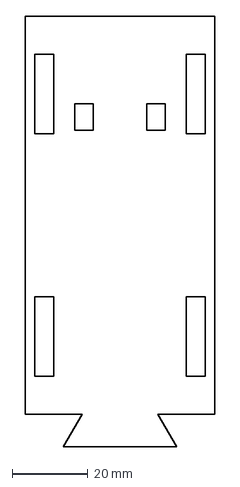
[picture p61: CAD file, 2026-04-29]
Project/CAD/sorting/New Wood/insideslide.dxf
50.0 x 113.7 mm
