dany2701/BOM-project/Project/CAD/sorting/New Wood/middleslideblocks.dxf

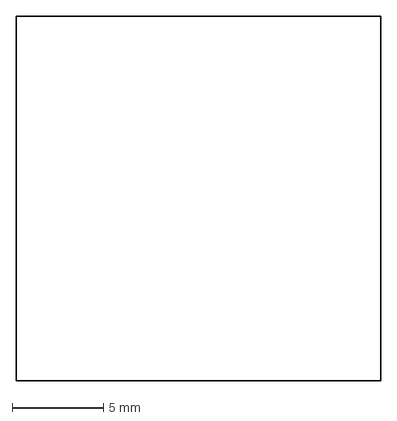
[picture p62: CAD file, 2026-04-29]
Project/CAD/sorting/New Wood/middleslideblocks.dxf
20.0 x 20.0 mm
