dany2701/BOM-project/Project/CAD/sorting/New Wood/Gate.dxf

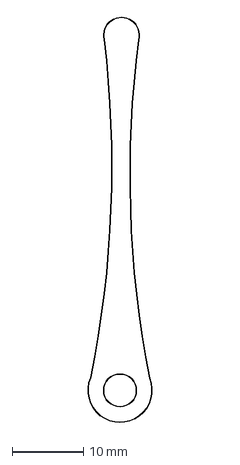
[picture p63: CAD file, 2026-04-29]
Project/CAD/sorting/New Wood/Gate.dxf
9.89 x 57.5 mm
