dany2701/BOM-project/Project/CAD/sorting/New Wood/motorholder1x2.dxf

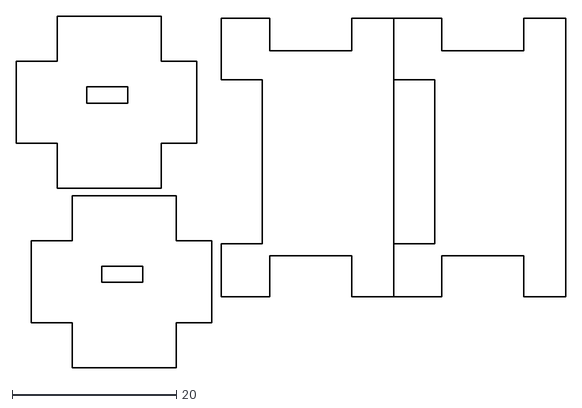
[picture p64: CAD file, 2026-04-29]
Project/CAD/sorting/New Wood/motorholder1x2.dxf
67.0 x 42.9
