dany2701/BOM-project/(list of files, cad)

Other CAD files:
Project/CAD/gear.dwg
Project/CAD/5mmhieght.ipt
Project/CAD/Ball Joint.SLDASM
Project/CAD/Lifting/Lifting Mechanism/Assembly2.iam
Project/CAD/Lifting/Lifting Mechanism/IRsensorhub.ipt
Project/CAD/Lifting/Lifting Mechanism/IRsensors/IRsensors/90headerMale.ipt
Project/CAD/Lifting/Lifting Mechanism/IRsensors/IRsensors/IRboard.ipt
Project/CAD/Lifting/Lifting Mechanism/IRsensors/IRsensors/IRsensors.iam
Project/CAD/Lifting/Lifting Mechanism/IRsensors/IRsensors/blackLEDIRsensor.ipt
Project/CAD/Lifting/Lifting Mechanism/IRsensors/IRsensors/smdChip8pin.ipt
Project/CAD/Lifting/Lifting Mechanism/IRsensors/IRsensors/smdLED.ipt
Project/CAD/Lifting/Lifting Mechanism/IRsensors/IRsensors/smdResistor101.ipt
Project/CAD/Lifting/Lifting Mechanism/IRsensors/IRsensors/smdResistor102.ipt
Project/CAD/Lifting/Lifting Mechanism/IRsensors/IRsensors/smdResistor103.ipt
Project/CAD/Lifting/Lifting Mechanism/IRsensors/IRsensors/smdTrimmerP103.ipt
Project/CAD/Lifting/Lifting Mechanism/IRsensors/IRsensors/smdceramiccapacitor.ipt
Project/CAD/Lifting/Lifting Mechanism/IRsensors/IRsensors/solder.ipt
Project/CAD/Lifting/Lifting Mechanism/IRsensors/IRsensors/whiteLEDIRsensor.ipt
Project/CAD/Lifting/Lifting Mechanism/Lifting Mechanism.ipt
Project/CAD/Lifting/Lifting Mechanism/OldVersions/Assembly2.0030.iam
Project/CAD/Lifting/Lifting Mechanism/OldVersions/IRsensorhub.0001.ipt
Project/CAD/Lifting/Lifting Mechanism/OldVersions/Part4.0016.ipt
Project/CAD/Lifting/Lifting Mechanism/OldVersions/partttt.0012.ipt
Project/CAD/Lifting/Lifting Mechanism/Part1.ipt
Project/CAD/Lifting/Lifting Mechanism/Part2.ipt
Project/CAD/Lifting/Lifting Mechanism/Part3.ipt
Project/CAD/Lifting/Lifting Mechanism/Part4.ipt
Project/CAD/Lifting/Lifting Mechanism/ball.ipt
Project/CAD/Lifting/Lifting Mechanism/base.ipt
Project/CAD/Lifting/Lifting Mechanism/coupler.ipt
Project/CAD/Lifting/Lifting Mechanism/ground.ipt
Project/CAD/Lifting/Lifting Mechanism/motor box 2.ipt
Project/CAD/Lifting/Lifting Mechanism/motor box.ipt
Project/CAD/Lifting/Lifting Mechanism/partttt.ipt
Project/CAD/Lifting/Lifting Mechanism/slide1.ipt
Project/CAD/Lifting/Lifting Mechanism/slide2.ipt
Project/CAD/Lifting/OldVersions/Assembly2.0012.iam
Project/CAD/Lifting/OldVersions/Lifting Mechanism.0011.ipt
Project/CAD/Lifting/OldVersions/Motor DC 16mm.0009.ipt
Project/CAD/Lifting/OldVersions/Part3.0004.ipt
Project/CAD/Lifting/OldVersions/Part4.0008.ipt
Project/CAD/Lifting/OldVersions/base.0004.ipt
Project/CAD/Lifting/OldVersions/motor box.0004.ipt
Project/CAD/Main.iam
Project/CAD/Not needed/Assembly2.iam
Project/CAD/Not needed/Ball Joint.iam
Project/CAD/Not needed/Ball Joint/Ball Joint/Ball.ipt
Project/CAD/Not needed/Ball Joint/Ball Joint/Base.ipt
Project/CAD/Not needed/Ball Joint/Ball/Ball.ipt
Project/CAD/Not needed/Ball Joint/Ball/OldVersions/Ball.0001.ipt
Project/CAD/Not needed/Ball Joint/Base/Base.ipt
Project/CAD/Not needed/Ball Joint/Base/OldVersions/Base.0001.ipt
Project/CAD/Not needed/Lifting Mechanism.ipt
Project/CAD/Not needed/Lifting/Lifting Mechanism.ipt
Project/CAD/Not needed/Lifting/Motor DC 16mm.ipt
Project/CAD/Not needed/Lifting/OldVersions/Assembly2.0017.iam
Project/CAD/Not needed/Lifting/OldVersions/Lifting Mechanism.0016.ipt
Project/CAD/Not needed/Lifting/OldVersions/Motor DC 16mm.0010.ipt
Project/CAD/Not needed/Lifting/OldVersions/Part3.0008.ipt
Project/CAD/Not needed/Lifting/OldVersions/Part4.0010.ipt
Project/CAD/Not needed/Lifting/OldVersions/ball.0001.ipt
Project/CAD/Not needed/Lifting/OldVersions/base.0006.ipt
Project/CAD/Not needed/Lifting/OldVersions/liftingAssembly2.0019.iam
Project/CAD/Not needed/Lifting/OldVersions/partttt.0008.ipt
Project/CAD/Not needed/Lifting/OldVersions/slide1.0004.ipt
Project/CAD/Not needed/Lifting/Part1.ipt
Project/CAD/Not needed/Lifting/Part2.ipt
Project/CAD/Not needed/Lifting/Part3.ipt
Project/CAD/Not needed/Lifting/Part4.ipt
Project/CAD/Not needed/Lifting/ball.ipt
Project/CAD/Not needed/Lifting/base.ipt
Project/CAD/Not needed/Lifting/liftingAssembly2.iam
Project/CAD/Not needed/Lifting/motor box.ipt
Project/CAD/Not needed/Lifting/partttt.ipt
Project/CAD/Not needed/Lifting/slide1.ipt
Project/CAD/Not needed/Lifting/slide2.ipt
Project/CAD/Not needed/Motor DC 16mm.ipt
Project/CAD/Not needed/Part1.ipt
Project/CAD/Not needed/Part2.ipt
Project/CAD/Not needed/Part27.ipt
Project/CAD/Not needed/Part3.ipt
Project/CAD/Not needed/Part4.ipt
Project/CAD/Not needed/Sensorroom.ipt
Project/CAD/Not needed/Shooting Mechanism CAD/622162x20.ipt
Project/CAD/Not needed/Shooting Mechanism CAD/Base.ipt
Project/CAD/Not needed/Shooting Mechanism CAD/Body.ipt
Project/CAD/Not needed/Shooting Mechanism CAD/Dc Motor 3mm D Shaft.ipt
Project/CAD/Not needed/Shooting Mechanism CAD/FT7635M_Servo assembly.iam
Project/CAD/Not needed/Shooting Mechanism CAD/FT7635M_Servo assembly_with T_BAR.iam
Project/CAD/Not needed/Shooting Mechanism CAD/Fleetech_FK-AP-4 (50 - 6) T-BAR.ipt
Project/CAD/Not needed/Shooting Mechanism CAD/Multiple_spline_mount.ipt
Project/CAD/Not needed/Shooting Mechanism CAD/OldVersions/Base.0010.ipt
Project/CAD/Not needed/Shooting Mechanism CAD/OldVersions/Dc Motor 3mm D Shaft.0002.ipt
Project/CAD/Not needed/Shooting Mechanism CAD/OldVersions/FT7635M_Servo assembly.0002.iam
Project/CAD/Not needed/Shooting Mechanism CAD/OldVersions/FT7635M_Servo assembly_with T_BAR.0002.iam
Project/CAD/Not needed/Shooting Mechanism CAD/OldVersions/Shooting Mechanism Assembly.0011.iam
Project/CAD/Not needed/Shooting Mechanism CAD/OldVersions/flywheel.0005.ipt
Project/CAD/Not needed/Shooting Mechanism CAD/Shooting Mechanism Assembly.iam
Project/CAD/Not needed/Shooting Mechanism CAD/flywheel.ipt
Project/CAD/Not needed/ball.ipt
Project/CAD/Not needed/base.ipt
Project/CAD/Not needed/collectingbox.ipt
Project/CAD/Not needed/gate.ipt
Project/CAD/Not needed/middleslide.ipt
Project/CAD/Not needed/middleslide2.ipt
Project/CAD/Not needed/motor box.ipt
Project/CAD/Not needed/outside3.ipt
Project/CAD/Not needed/outside32.ipt
Project/CAD/Not needed/outside33.ipt
Project/CAD/Not needed/partttt.ipt
Project/CAD/Not needed/shooter handle.ipt
Project/CAD/Not needed/shootingstand.ipt
Project/CAD/Not needed/slide1.ipt
Project/CAD/Not needed/slide2.ipt
Project/CAD/OldVersions/Main.0011.iam
Project/CAD/OldVersions/baseb.0002.ipt
Project/CAD/OldVersions/collectingslide.0001.ipt
Project/CAD/OldVersions/collectionslideintoscrew.0001.ipt
Project/CAD/OldVersions/newcollection.0001.ipt
Project/CAD/OldVersions/storrageout.0002.ipt
Project/CAD/Shooting/0837 solenoid.iam
Project/CAD/Shooting/0837/0837 solenoid.iam
Project/CAD/Shooting/0837/0837 solenoid/Мастер проектирования/Пружина сжатия12.ipt
Project/CAD/Shooting/0837/0837 solenoid/Мастер проектирования/Пружина сжатия2.iam
Project/CAD/Shooting/0837/OldVersions/0837 solenoid.0005.iam
Project/CAD/Shooting/0837/OldVersions/base.0008.ipt
Project/CAD/Shooting/0837/OldVersions/coil.0002.ipt
Project/CAD/Shooting/0837/OldVersions/cover.0003.ipt
Project/CAD/Shooting/0837/OldVersions/frame.0001.ipt
Project/CAD/Shooting/0837/OldVersions/kern.0001.ipt
Project/CAD/Shooting/0837/OldVersions/nut.0001.ipt
Project/CAD/Shooting/0837/base.ipt
Project/CAD/Shooting/0837/coil.ipt
Project/CAD/Shooting/0837/cover.ipt
Project/CAD/Shooting/0837/frame.ipt
Project/CAD/Shooting/0837/kern.ipt
Project/CAD/Shooting/0837/nut.ipt
Project/CAD/Shooting/Acople circular.ipt
Project/CAD/Shooting/Assembly1.iam
Project/CAD/Shooting/Base.ipt
Project/CAD/Shooting/Eje.ipt
Project/CAD/Shooting/H-brug.ipt
Project/CAD/Shooting/MG_996R.iam
Project/CAD/Shooting/Medio.ipt
Project/CAD/Shooting/Mini Push Pull Solenoid 4mm.ipt
Project/CAD/Shooting/OldVersions/Assembly1.0006.iam
Project/CAD/Shooting/OldVersions/H-brug.0011.ipt
Project/CAD/Shooting/OldVersions/MG_996R.0004.iam
Project/CAD/Shooting/OldVersions/Mini Push Pull Solenoid 4mm.0001.ipt
Project/CAD/Shooting/OldVersions/Part2.0001.ipt
Project/CAD/Shooting/OldVersions/Rotating Base.0008.ipt
Project/CAD/Shooting/OldVersions/Servo Mount.0002.ipt
Project/CAD/Shooting/OldVersions/Servo Stand.0002.ipt
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
