dany2701/BOM-project/Project/CAD/Assembly2.png

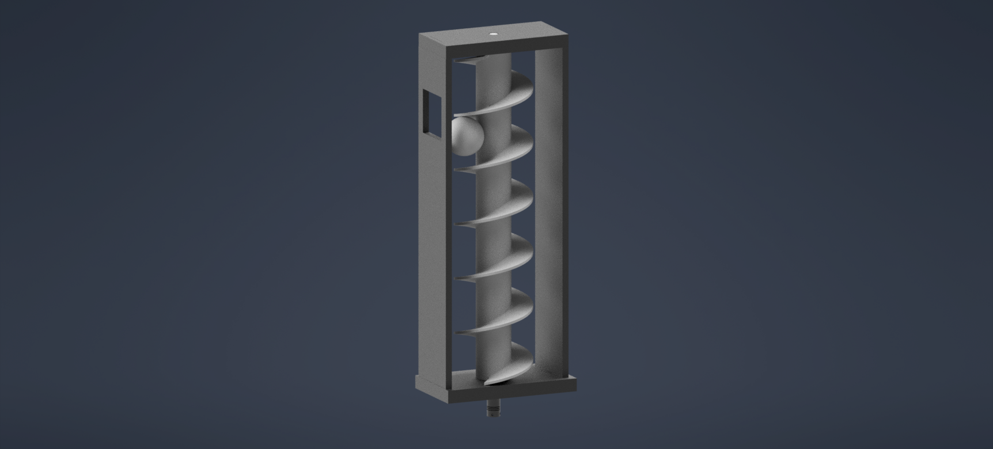
Project/CAD/Assembly2.png
