dany2701/BOM-project/Project/CAD/Shooting Mechanism Assembly FINAL 2.png

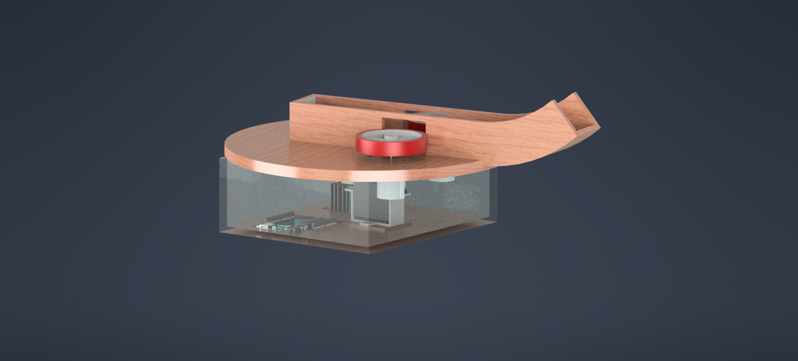
Project/CAD/Shooting Mechanism Assembly FINAL 2.png
