dany2701/BOM-project/Project/Documentation/Block diagram final (2).pdf

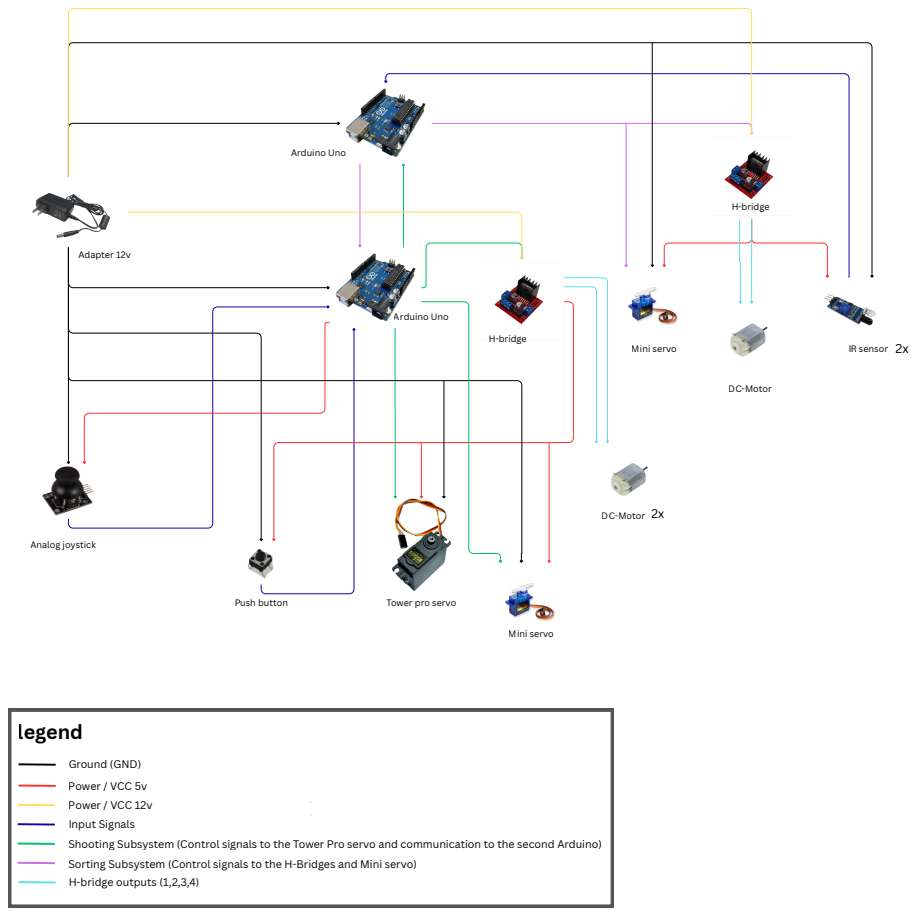
[picture p67: page 1]
Arduino Uno; H-bridge; IR sensor 2x Analog joystick; Push button; Tower pro servo; Mini servo; Arduino Uno Adapter 12v; DC-Motor legend; Ground (GND) Power / VCC 5v Input Signals Shooting Subsystem (Control signals to the Tower Pro servo and communication to the second Arduino) Sorting Subsystem (Control signals to the H-Bridges and Mini servo) Power / VCC 12v

DC-Motor H-bridge outputs (1,2,3,4)
