dany2701/BOM-project/Project/Documentation/Flowchart Whiteboard in Bright Green Lime Green Pink Corporate Neon Style.pdf

## START

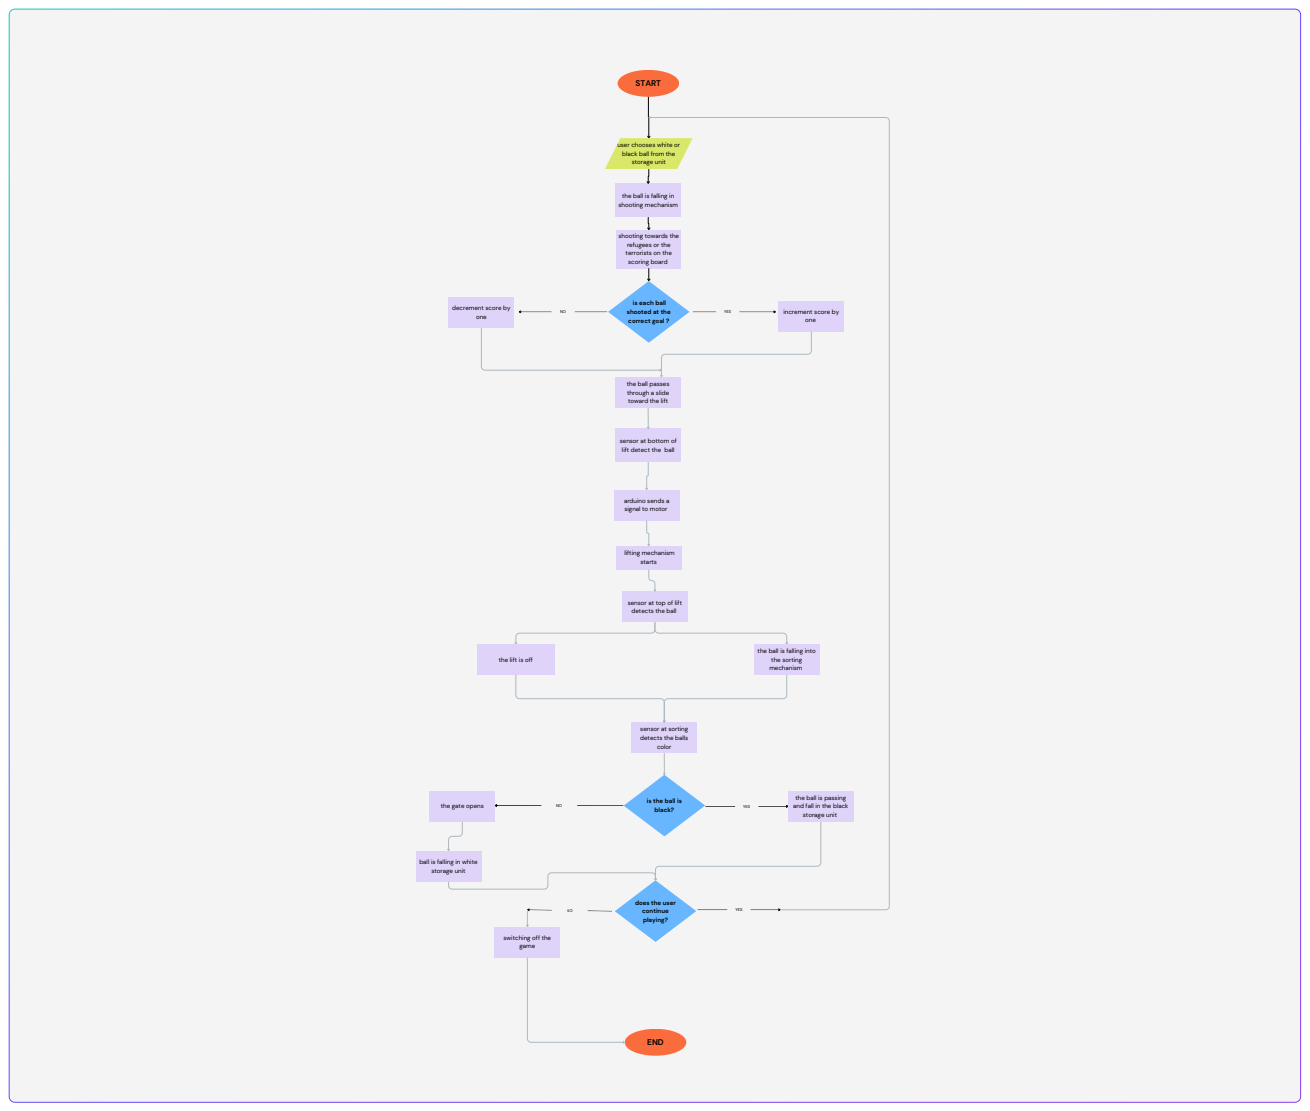
[picture p68: page 1]
END; YES; one; lifting mechanism starts

user chooses white or
black ball from the
storage unit

the ball is falling in
shooting mechanism

shooting towards the
refugees or the
terrorists on the
scoring board

is each ball
shooted at the
correct goal ?

decrement score by

increment score by
one

the ball passes
through a slide
toward the lift

sensor at bottom of
lift detect the ball

arduino sends a
signal to motor

sensor at top of lift
detects the ball

the ball is falling into
the sorting
mechanism

the lift is off

sensor at sorting
detects the balls
color

is the ball is
black?

the ball is passing
and fall in the black

the gate opens

ball is falling in white

does the user
continue
playing?

switching off the
game
