dany2701/BOM-project/(list of files, drawings)

Other design files:
Project/Electrical/Early PCB design.fzz
Project/Electrical/Proteus/LIFTING/lifting.pdsprj
Project/Electrical/Proteus/shooting/Shooting.pdsprj
Project/Electrical/Proteus/SORTING/New Project.pdsprj
