dany2701/BOM-project/(commit log)

2026-03-13 NEw lifting
    [Assembly2.0017.iam, Lifting Mechanism.0016.ipt, Lifting Mechanism.ipt, Motor DC 16mm.0010.ipt, Motor DC 16mm.ipt, Part1.ipt, Part2.ipt, Part3.0008.ipt]
2026-04-29 Removed all arduino files to avoid problems and upgraded all files after Major task
    [0837 solenoid.0005.iam, 0837 solenoid.iam, 0837 solenoid.stp, 2standx2.dxf, 622162x20.ipt, 90headerMale.ipt, Acople circular.ipt, Assembly1.0006.iam]
